abdulwaheedsyed/ESP32-2432S028R-enclosure/README.md

# ESP32-2432S028R (CYD2USB) 45° Desk Enclosure

A sturdy, support-free desk enclosure for the **ESP32-2432S028R "Cheap Yellow Display"**, dual-USB revision (micro-USB + USB-C, often called *CYD2USB*). The screen sits in landscape at 45°. The case is two PLA parts plus optional TPU end caps that act as bumpers and non-slip feet. A [JST cable-exit variant](#jst-cable-exit-variant) opens up the board's side connectors for sensors, serial and a speaker. Press-fit [lids](#lids) can close the microSD slot, and the micro-USB port while leaving USB-C open.

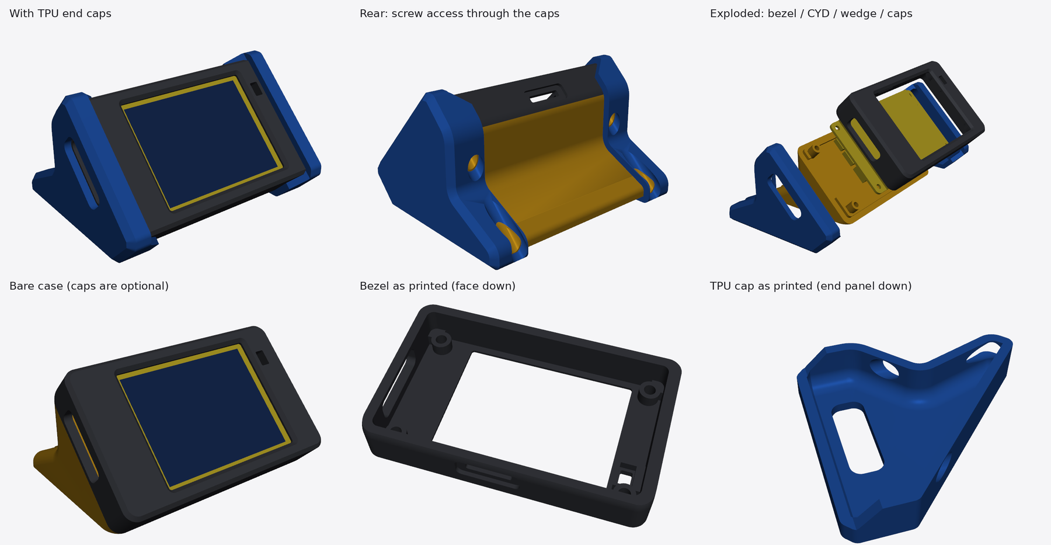
[picture p1: preview.png]
Preview


## Features

- **45° landscape desk wedge.** It's stable to use: it only tips back if the top edge of the screen is pressed with about 1 kgf.
- **Prints without supports**: the bezel prints face down, the wedge on its flat base.
- **Hidden screws:** four M3 screws go in from underneath and the back, into heat-set inserts. A self-tapping version is also included.
- **Recessed screen:** the bezel stands 3.5 mm proud of the glass. A 1 mm air gap means the bezel never presses on the resistive touch panel, so it doesn't cause phantom touches.
- **Firmly mounted board:** the PCB is clamped at all four mounting holes, and a locating ridge keys the two halves together.
- **Light sensor (LDR) window** with a baffle so the backlight doesn't fool the auto-brightness.
- **Port access:** USB-C and micro-USB at the left end, and microSD at the top-back edge with a fingernail pocket.
- **Optional TPU end caps:** they cover all eight corners, and their base strips work as grippy feet.
- **Optional JST cable-exit variant:** ports for the P1, P3, CN1 and speaker connectors, so cables plug in from outside.
- **Optional lids:** a flush microSD cover, and a USB lid that covers micro-USB and leaves only USB-C open.

| | Size (W × D × H) |
|---|---|
| Bare case | 96 × 76 × 51 mm |
| With TPU caps | 102 × 82 × 57 mm |

## Compatibility

The case is designed for the **dual-USB ESP32-2432S028R (CYD2USB)**. The single-micro-USB original CYD has the same outline and hole pattern, so it should fit too, but that hasn't been tested.

The exact USB-C and micro-USB positions aren't published for the dual-USB board. The USB end therefore has one generous slot (26.8 × 8.5 mm). Please print the fit-test piece first (see below).

## Files

| File | Material | Print orientation |
|---|---|---|
| `CYD2USB_wedge_front_bezel_heatset.stl` | PLA | Face down (as exported) |
| `CYD2USB_wedge_front_bezel_selftap.stl` | PLA | Face down. Use instead of the heat-set version if you have no inserts |
| `CYD2USB_wedge_rear_wedge.stl` | PLA | On its flat base (as exported) |
| `CYD2USB_wedge_fit_test_usb_end.stl` | PLA | Face down. A 15-minute check of the USB slot |
| `CYD2USB_wedge_tpu_cap_usb_end.stl` | TPU | End panel down (as exported). Has the USB opening |
| `CYD2USB_wedge_tpu_cap_sensor_end.stl` | TPU | End panel down (as exported) |
| `CYD2USB_wedge_jst_front_bezel_heatset.stl` | PLA | JST variant of the bezel. Face down |
| `CYD2USB_wedge_jst_front_bezel_selftap.stl` | PLA | JST variant, self-tap version. Face down |
| `CYD2USB_wedge_jst_tpu_cap_usb_end.stl` | TPU | JST variant of the USB-end cap. End panel down |
| `CYD2USB_wedge_jst_fit_test.stl` | PLA | Face down. L-shaped check of the USB end and the microSD-side ports |
| `CYD2USB_wedge_lid_microsd.stl` | TPU (or PLA) | Outer face down (as exported). Covers the microSD slot |
| `CYD2USB_wedge_lid_usb_c_only.stl` | TPU (or PLA) | Flange down (as exported). Covers micro-USB, leaves USB-C open |
| `CYD2USB_wedge_jst_lid_usb_c_and_p1.stl` | TPU (or PLA) | Flange down (as exported). JST variant: covers micro-USB, leaves USB-C and P1 open |
| `CYD2USB_wedge_assembly.step` | — | Assembled model for CAD (standard version) |
| `cyd_wedge_case.py` | — | Parametric CadQuery source for everything above |

## Bill of materials

| Qty | Part | Notes |
|---|---|---|
| 4 | M3 × 16 socket-head screw (ISO 4762 / DIN 912) | M3 × 14 also works. **Don't use anything longer than 16 mm**, or it will push through the bezel face |
| 4 | M3 heat-set insert, 4 or 5.7 mm long, OD 4.5–5 mm | Hole is 4.1 mm. Not needed for the self-tap bezel |
| 4 | Stick-on rubber feet, Ø10 mm | Optional if you use the TPU caps |
| ~90 g | PLA (PLA+, PETG or ASA also work) | Bezel ≈ 25 g, wedge ≈ 60 g |
| ~35 g | TPU 95A | For the two end caps (the lids need under 1 g) |

## Printing

### PLA parts

| Setting | Value |
|---|---|
| Layer height | 0.2 mm |
| Walls | 6 (the bezel walls come out solid) |
| Top / bottom layers | 6 / 6 |
| Infill (wedge) | 35 % gyroid |
| Nozzle temperature | Upper end of your filament's range, for strong layer bonding |
| Supports | None |

### TPU end caps

| Setting | Value |
|---|---|
| Material | TPU 95A |
| Layer height | 0.2 mm |
| Walls / infill | 4 walls, 100 % infill (the caps are thin, so this keeps them solid) |
| Speed | 20–30 mm/s |
| Supports | None. Print with the flat end panel on the bed |

The caps are a stretch fit: their inside is modelled 0.15 mm smaller than the case. If they come out too tight or too loose on your printer, scale the cap's X/Y by ±0.5 % in your slicer.

## Before you print: USB fit test

1. Print `CYD2USB_wedge_fit_test_usb_end.stl`. It's the USB end of the bezel and takes about 15 minutes.
2. Set the USB end of your board into it, screen side down. The two mounting holes should line up with the two bosses.
3. Plug in a USB-C and a micro-USB cable. Both should seat fully without the plug bodies hitting the slot.

If they don't fit, adjust `USB_Y0`, `USB_Y1`, `USB_Z0` and `USB_Z1` in `cyd_wedge_case.py` and regenerate (see [Customising](#customising)).

## Assembly

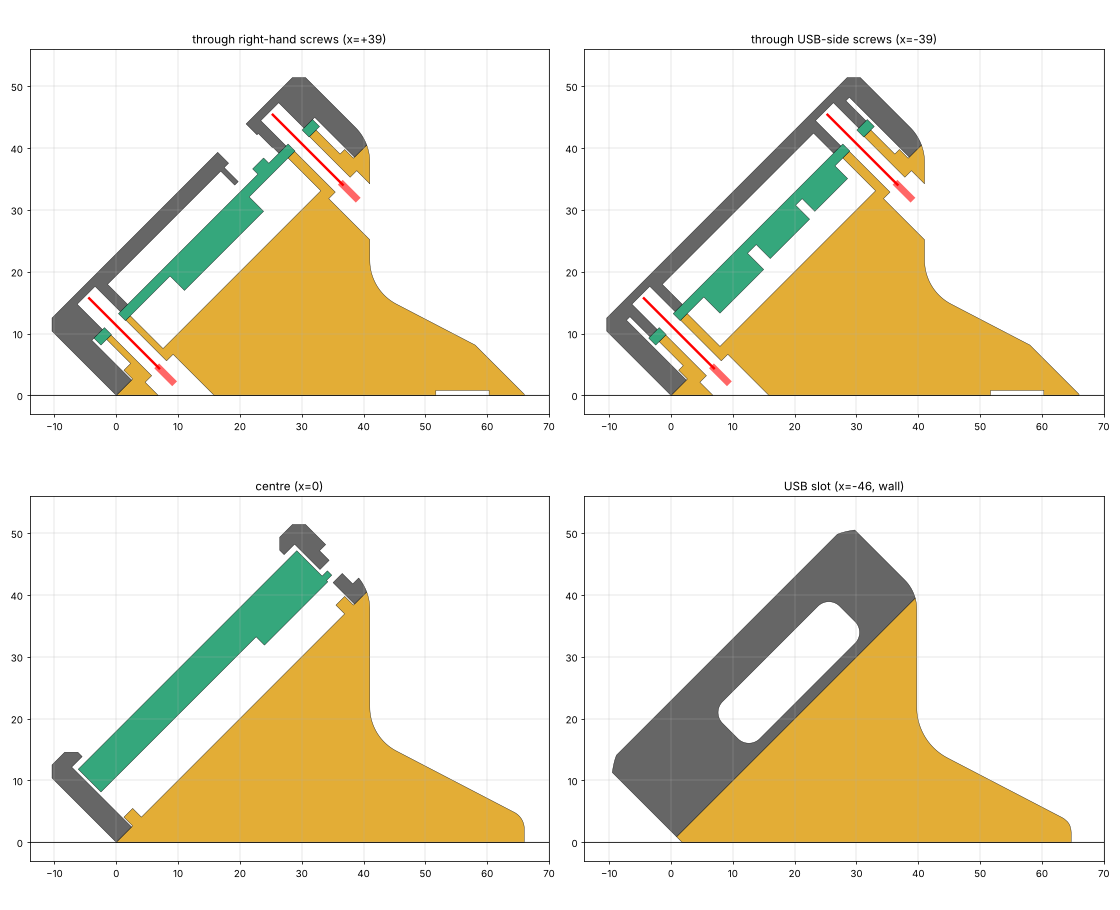
[picture p2: cross_sections.png]
Cross-sections


1. **Inserts:** press the four heat-set inserts into the bezel bosses with a soldering iron (about 220 °C for PLA) until they're flush.
2. **Board:** lay the bezel face down. Place the CYD screen first, with the USB ports at the slot end. The light sensor sits under the small rectangular window.
3. **Wedge:** lower the wedge onto the back of the board. The ridge slides inside the bezel walls, and the posts land on the PCB mounting holes.
4. **Screws:** drive two screws from underneath and two from the vertical back face, through the posts and PCB into the inserts. Tighten until snug and no further.
5. **Caps or feet:** stretch the TPU caps over each end; the cap with the slot goes on the USB end. The screw heads stay reachable through holes in the caps. If you don't use the caps, stick rubber feet into the four recesses on the base.

On the desk the USB ports are on the **left**. If your UI shows upside down, swap `setRotation(1)` and `setRotation(3)`.

## JST cable-exit variant

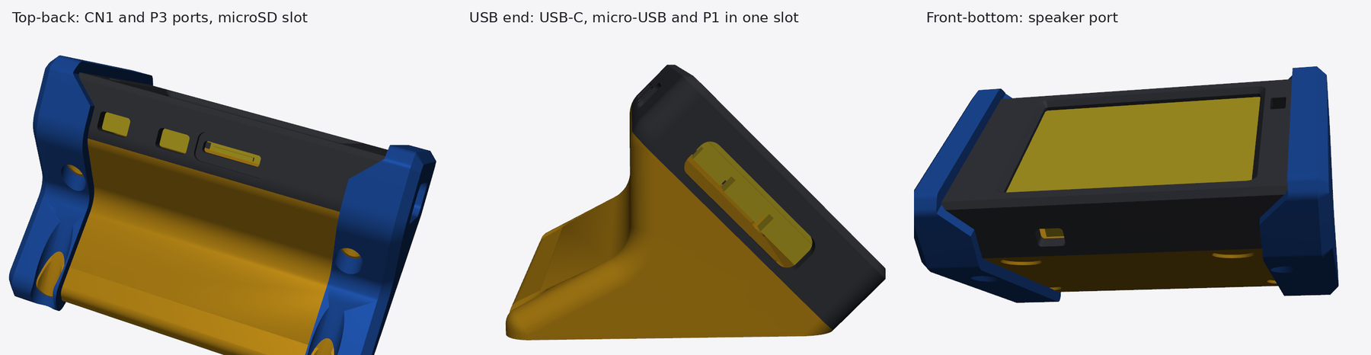
[picture p3: preview_jst.png]
JST cable-exit variant


The CYD's 1.25 mm connectors are side-entry, with their openings at the board edges, so the standard case covers them. The JST variant puts a plug-sized port in the wall in front of each connector. Plugs go in from outside without opening the case, and the cables leave through the port.

| Connector | Pins | Where it exits |
|---|---|---|
| P3 (4-pin) | GND, IO35 (input only), IO22, IO21 (backlight) | Top-back edge, next to the microSD slot |
| CN1 (4-pin) | GND, IO22, IO27, 3.3 V. Good for I²C sensors | Top-back edge, next to the microSD slot |
| P1 (4-pin) | VIN, TX, RX, GND (serial / power in) | USB end. The USB slot is extended to cover it |
| P4 (2-pin) | Speaker output from the on-board amplifier | Front-bottom edge |

All four are 1.25 mm Molex PicoBlade (often sold as "JST 1.25" or "MX1.25").

To build it, use `CYD2USB_wedge_jst_front_bezel_heatset.stl` (or the self-tap version) in place of the standard bezel. With TPU caps, use `CYD2USB_wedge_jst_tpu_cap_usb_end.stl` at the USB end. The rear wedge and the sensor-end cap are the same as the standard version.

- The port positions come from the manufacturer's interface drawing, which is accurate to about 1 mm. Each port leaves about 1 mm of clearance around the plug. Print `CYD2USB_wedge_jst_fit_test.stl` first; it uses three of the mounting bosses to locate the board.
- The speaker cable exits close to the desk, so route it out to the side.
- The microSD fingernail pocket is a little narrower in this variant, to leave a solid web next to CN1.

## Lids

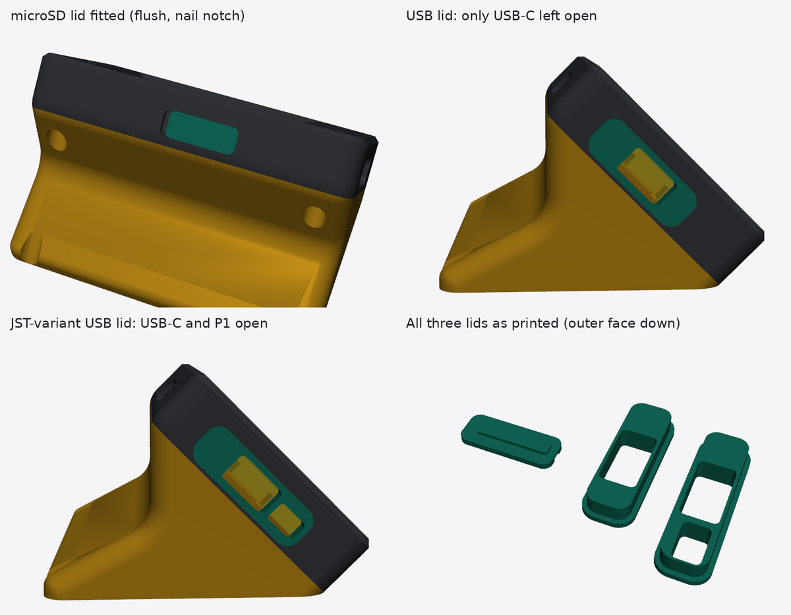
[picture p4: preview_lids.png]
Lids


Small press-fit lids close openings you don't use. All of them work with or without the TPU end caps.

- **microSD lid** (`CYD2USB_wedge_lid_microsd.stl`). It sits flush in the fingernail pocket, and a short tongue goes into the card slot, stopping 0.75 mm short of the card. Pry it out with a fingernail at the notched end. The same lid fits both the standard and the JST bezel.
- **USB lid** (`CYD2USB_wedge_lid_usb_c_only.stl`). It fills the USB slot and leaves an opening only for a USB-C plug, which clears the USB-C spec's largest overmold (12.35 × 6.5 mm). A thin outer flange stops it going in too far; with the TPU cap fitted, the flange sits inside the cap's opening. To remove it, hook a fingernail in the USB-C opening and pull. This lid fits the standard bezel.
- **JST-variant USB lid** (`CYD2USB_wedge_jst_lid_usb_c_and_p1.stl`). This is the same idea for the JST bezel's longer slot. It covers micro-USB and has two openings, one for the USB-C plug and one for the P1 serial/power plug, with a 1.3 mm web between them. It also fits inside the JST variant's TPU cap.

**Print** in TPU 95A with the outer face on the bed, no supports, for a snug press fit. PLA works too: set `LID_CLR = 0.15` in the script and regenerate, or scale the lid down about 1 % in your slicer.

**USB-C position.** The positions of the two USB ports on the dual-USB board aren't documented. Both USB lids assume USB-C is nearer the middle of the short edge and micro-USB nearer the microSD side. Check it against your board, or against the USB fit-test piece, before printing. If yours differs, change `USBC_Y` in the script; it's the USB-C centre, measured along the short edge from the board centre, positive towards the microSD side.

## Customising

Everything is generated by `cyd_wedge_case.py` ([CadQuery](https://cadquery.readthedocs.io/)):

```bash
pip install cadquery trimesh
python3 cyd_wedge_case.py
```

Useful parameters at the top of the file:

| Parameter | What it controls |
|---|---|
| `USB_Y0`, `USB_Y1`, `USB_Z0`, `USB_Z1` | USB slot position and size |
| `SD_X0`, `SD_X1`, `SD_Z0`, `SD_Z1` | microSD slot position and size |
| `DISP_TOP`, `FACE_IN` | Display height and the air gap above it |
| `INSERT_D`, `SELFTAP_D` | Insert hole and self-tap pilot hole diameters |
| `HEEL_Y` | Base depth (stability against tipping) |
| `CAP_T`, `CAP_LIP`, `CAP_FACE_LIP`, `CAP_GRIP` | TPU cap thickness, wrap-around and fit |
| `JST_TOP`, `JST_BOTTOM`, `JST_Z0`, `JST_Z1`, `USB_Y0_JST` | JST port positions and sizes (variant only) |
| `USBC_Y`, `USBC_Z`, `USBC_OPEN_W`, `USBC_OPEN_H` | USB-C opening in the USB lids |
| `P1_Y`, `P1_OPEN_W` | P1 opening in the JST-variant USB lid |
| `LID_CLR`, `SD_LID_DEPTH` | Lid press-fit clearance and the microSD tongue depth |

## Notes and limitations

- **Not reachable once assembled:**
  - the **BOOT/RESET buttons**. Normal USB flashing doesn't need them, because the board auto-resets; unplug USB to power-cycle.
  - the **side JST connectors** (serial/power, extended IO, CN1, speaker) in the standard version. Use the [JST cable-exit variant](#jst-cable-exit-variant) if you need them.
  - the **RGB LED** on the back.
- **USB-C power:** the USB-C port on the CYD2USB has no CC resistors, so USB-C-to-C cables often don't power it. Use a USB-A-to-C cable, or the micro-USB port.
- **Heat:** PLA softens above about 55 °C, so don't leave the case in a hot car or in direct sun behind glass.
- **Drop resistance:** the case is built to take everyday knocks, but it hasn't been formally drop-tested.

## Design references

- ESP32-2432S028R specification and dimension drawing, and the JC2432A028N LCD datasheet (Shenzhen Jingcai Intelligent). These are mirrored in [witnessmenow/ESP32-Cheap-Yellow-Display](https://github.com/witnessmenow/ESP32-Cheap-Yellow-Display).
- The screen window and light-sensor positions were cross-checked against the community cases in that repository.
- Connector pinouts are from the same repository's [PINS.md](https://github.com/witnessmenow/ESP32-Cheap-Yellow-Display/blob/main/PINS.md).

This project is not affiliated with the board's manufacturer.

## Contributing

Issues and pull requests are welcome. These would be especially useful:

- **Measured USB and JST port positions** for your board revision, so the openings can be tightened.
- Photos of your print, and notes on what fit and what didn't.
- Variants: button access, a light pipe for the RGB LED, other tilt angles.

## License

- **3D models, images and documentation:** © 2026 Syed Abdul Waheed, licensed under [CC BY-NC-SA 4.0](https://creativecommons.org/licenses/by-nc-sa/4.0/); see [`LICENSE`](LICENSE). You can share and remix them for non-commercial purposes, with attribution, under the same license.
- **Source code** (`cyd_wedge_case.py`): © 2026 Syed Abdul Waheed, licensed under the [MIT License](LICENSE-MIT).
