abdulwaheedsyed/ESP32-2432S028R-enclosure/CYD2USB_wedge_assembly.step

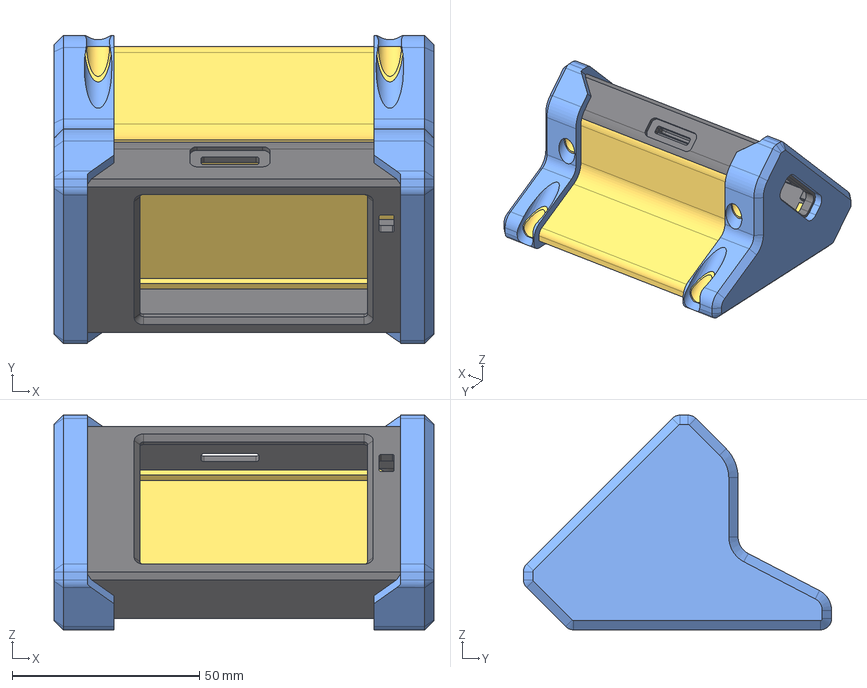
[picture p5: CAD file, 2026-10-28]
CYD2USB_wedge_assembly.step
101.6 x 82.4 x 57.4 mm
front_bezel
rear_wedge
tpu_cap_usb_end
tpu_cap_sensor_end
