abdulwaheedsyed/ESP32-2432S028R-enclosure/CYD2USB_wedge_jst_lid_usb_c_and_p1.stl

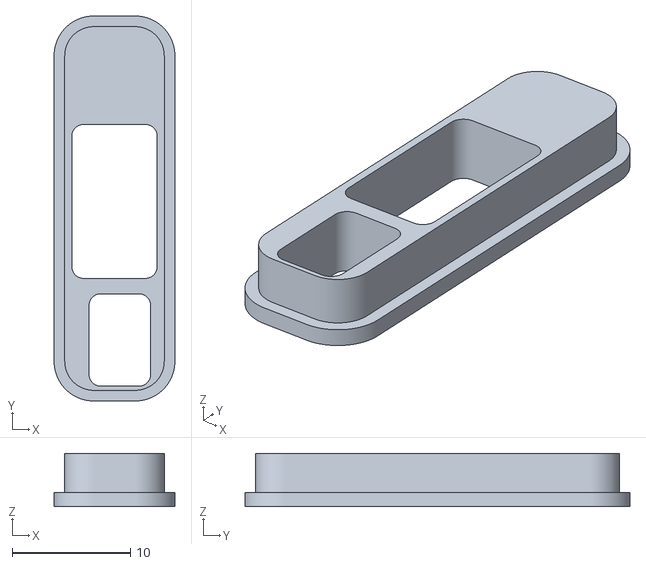
[picture p6: CAD file, 2026-11-01]
CYD2USB_wedge_jst_lid_usb_c_and_p1.stl
10.2 x 32.5 x 4.50
