abdulwaheedsyed/ESP32-2432S028R-enclosure/CYD2USB_wedge_lid_usb_c_only.stl

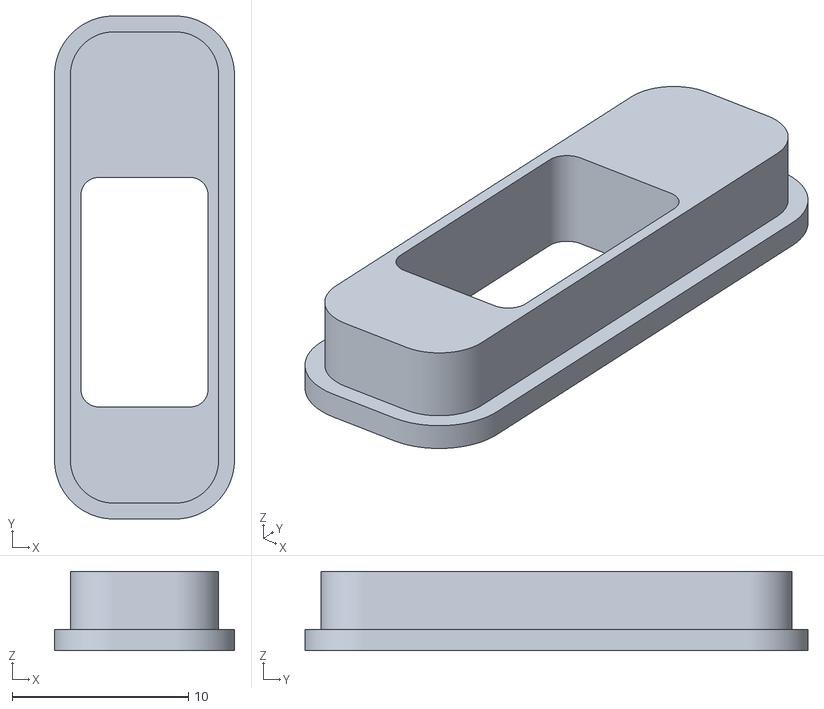
[picture p7: CAD file, 2026-11-01]
CYD2USB_wedge_lid_usb_c_only.stl
10.2 x 28.5 x 4.50
