abdulwaheedsyed/ESP32-2432S028R-enclosure/CYD2USB_wedge_lid_microsd.stl

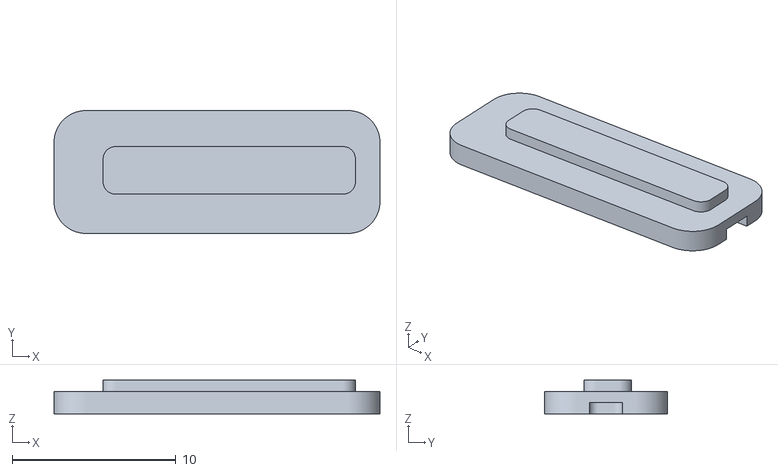
[picture p8: CAD file, 2026-11-01]
CYD2USB_wedge_lid_microsd.stl
19.9 x 7.50 x 2.05
