abdulwaheedsyed/ESP32-2432S028R-enclosure/CYD2USB_wedge_jst_fit_test.stl

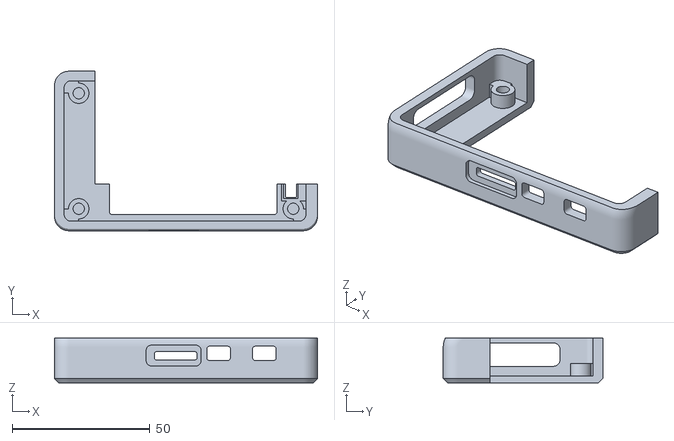
[picture p11: CAD file, 2026-10-28]
CYD2USB_wedge_jst_fit_test.stl
95.6 x 58.0 x 16.2
