abdulwaheedsyed/ESP32-2432S028R-enclosure/CYD2USB_wedge_tpu_cap_sensor_end.stl

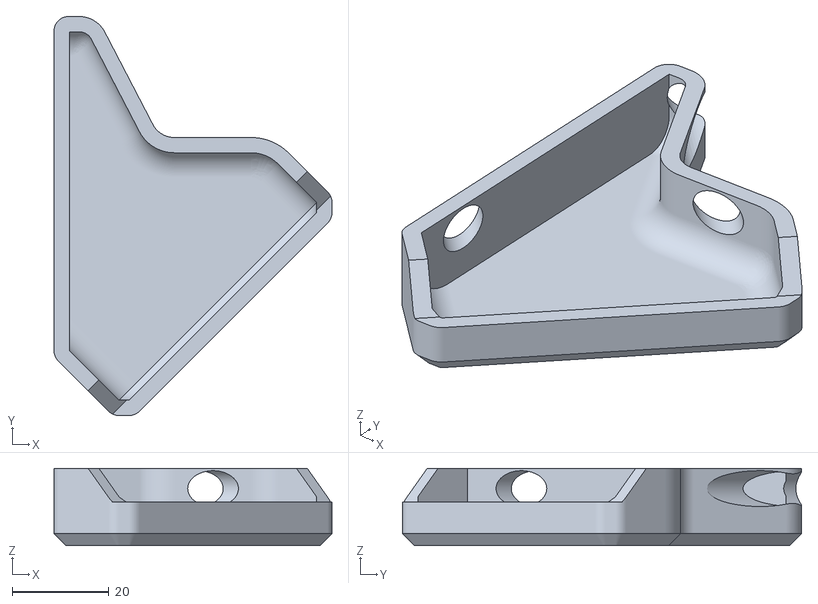
[picture p12: CAD file, 2026-10-28]
CYD2USB_wedge_tpu_cap_sensor_end.stl
57.4 x 82.4 x 16.0
