abdulwaheedsyed/ESP32-2432S028R-enclosure/CYD2USB_wedge_fit_test_usb_end.stl

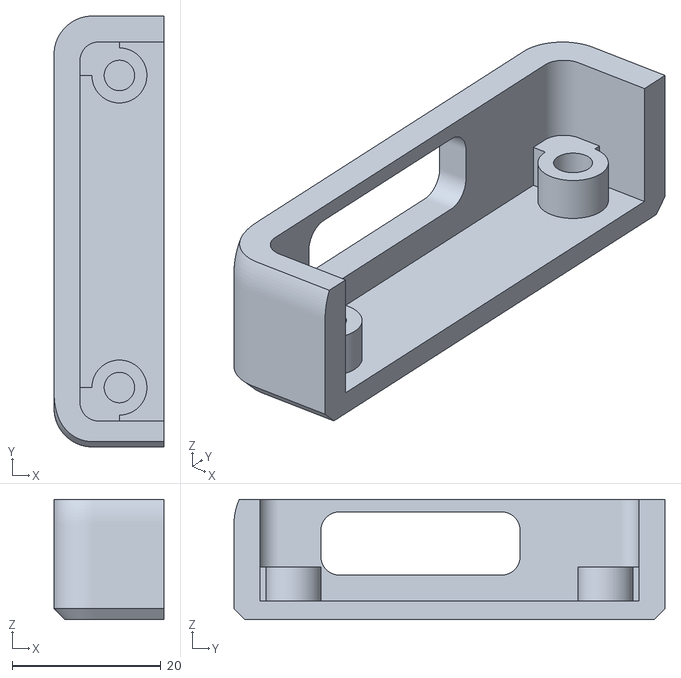
[picture p13: CAD file, 2026-10-28]
CYD2USB_wedge_fit_test_usb_end.stl
14.8 x 58.0 x 16.2
