abdulwaheedsyed/ESP32-2432S028R-enclosure/CYD2USB_wedge_rear_wedge.stl

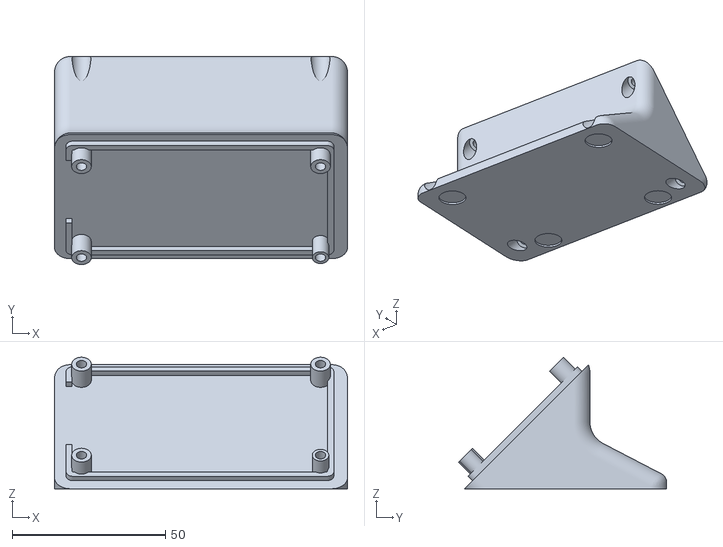
[picture p14: CAD file, 2026-10-28]
CYD2USB_wedge_rear_wedge.stl
95.6 x 67.9 x 42.9
