abdulwaheedsyed/ESP32-2432S028R-enclosure/(list of files, cad)

Other CAD files:
CYD2USB_wedge_jst_front_bezel_selftap.stl
CYD2USB_wedge_tpu_cap_usb_end.stl
CYD2USB_wedge_front_bezel_selftap.stl
CYD2USB_wedge_front_bezel_heatset.stl
