abdulwaheedsyed/ESP32-2432S028R-enclosure/(commit log)

2026-10-28 Add rugged 45-degree desk wedge enclosure for ESP32-2432S028R (CYD2USB)
    Two-part, support-free PLA enclosure for the dual-USB Cheap Yellow Display:
    front bezel (heat-set insert and self-tap variants), rear wedge stand,
    USB-end fit-test piece, assembly STEP, parametric CadQuery source,
    and print/assembly guide.
    [CYD2USB_wedge_assembly.step, CYD2USB_wedge_fit_test_usb_end.stl, CYD2USB_wedge_front_bezel_heatset.stl, CYD2USB_wedge_front_bezel_selftap.stl, CYD2USB_wedge_rear_wedge.stl]
2026-10-28 Add TPU end caps and rewrite README for public release
    - Two optional TPU 95A end caps that wrap all eight corners, double as
    non-slip feet, and keep the screw heads, USB slot, screen and light
    sensor uncovered
    - README reworked as a public project page: features, compatibility,
    bill of materials, PLA and TPU print settings, fit test, assembly,
    customising, limitations, references, contributing and license
    - SPDX license header in the generator script
    [CYD2USB_wedge_assembly.step, CYD2USB_wedge_tpu_cap_sensor_end.stl, CYD2USB_wedge_tpu_cap_usb_end.stl]
2026-10-28 Add JST cable-exit variant
    Variant bezel (heat-set and self-tap) with plug-sized ports in front of
    the side-entry 1.25 mm connectors: P3 and CN1 on the microSD wall, the
    speaker connector on the bottom wall, and the USB slot extended over P1.
    Matching USB-end TPU cap and an L-shaped fit-test piece. The rear wedge
    and sensor-end cap are shared with the standard version. README gains
    a variant section with the connector pinouts.
    [CYD2USB_wedge_jst_fit_test.stl, CYD2USB_wedge_jst_front_bezel_heatset.stl, CYD2USB_wedge_jst_front_bezel_selftap.stl, CYD2USB_wedge_jst_tpu_cap_usb_end.stl]
2026-11-01 Add microSD lid and USB-C-only USB lid
    - microSD lid: flush press-fit cover for the fingernail pocket with a
    short tongue that stops short of the card; fits the standard and the
    JST bezel
    - USB lid: fills the USB slot and leaves only a USB-C plug opening, with
    an outer flange that also fits inside the TPU end cap's opening
    - USB-C position, opening size and press-fit clearance are parameters;
    README documents the assumed port layout
    [CYD2USB_wedge_lid_microsd.stl, CYD2USB_wedge_lid_usb_c_only.stl]
2026-11-01 Add USB lid for the JST variant
    Covers micro-USB in the JST bezel's longer slot and leaves openings for
    the USB-C plug and the P1 serial/power plug. P1 position and opening
    width are parameters; README and lids preview updated.
    [CYD2USB_wedge_jst_lid_usb_c_and_p1.stl]
